budarriola/SolderingIronDriver/README.md

# SolderingIronDriver
Soldering Iron Driver
