budarriola/SolderingIronDriver/Error Log And ToDo List.rtf

Soldering iron Driver Rev. A error log

Problem:
U5 and U3 VSS and VDD are reversed replace I.C. with mcp601R or do mod to correct pins 2/5
Action:
Corrected in new rev. schematic / rev a boards use mcp601r instead

Problem:
R28 is too close to J4
Action:
Moved part on new pcb

Problem:
Potential problem if any button pin was set to output / conflict with programmer
Action:
Added series resistors to button inputs

Problem:
R20 inaccessible when lcd is installed
Action:
moved to other side on new board

Problem:
Serial port TX was not strong enough to push the signal into the adapter
Action:
Changed R9 to 100ohm

Problem:
Leds are too bright
Action:
Increced the value of r18 and r19

ToDo
• Add test points for listed signals
o Vcc, Gnd*2, temp1, temp2, Vref, Heater1, Heater2, Oxing, programing Header, serial port, buttons
• Change L1 from SRR6038-270Y to SRR4018-270Y (http://www.mouser.com/ProductDetail/Bourns/SRR4018-270Y/)
• Change D1, D4, D5, D6, D7 from B360 to B160-E3/5AT (http://www.mouser.com/ProductDetail/Vishay-Semiconductors/B160-E3-5AT/)
• Update terminal block silk screen / make terminal block holes for power sections larger
• Update electrolytic cap silk screen
• Update PCB
