budarriola/SolderingIronDriver/Hardware/sch.jpg

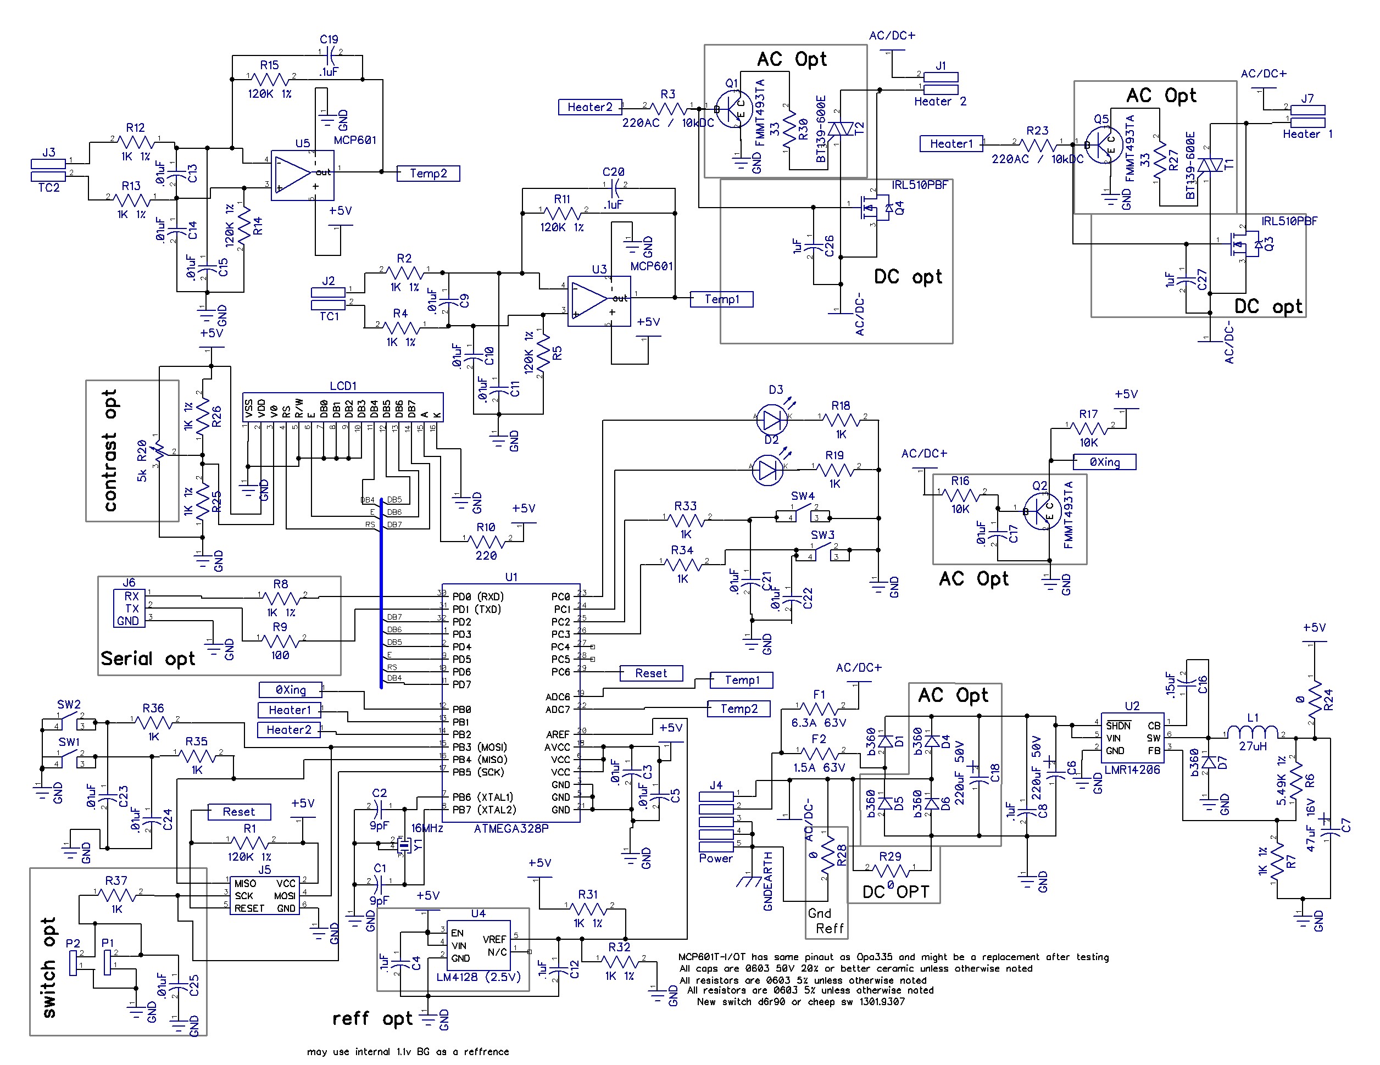
Hardware/sch.jpg
