budarriola/SolderingIronDriver/(list of files, drawings)

Other design files:
Hardware/Gerbers/pcb.dip
Hardware/Gerbers/soldering Station.dch
Hardware/pcb.dip
Hardware/soldering Station.dch
