budarriola/SolderingIronDriver/Software/Soldering Iron Driver/Thermocouple.h

#ifndef Thermocouple_H
#define Thermocouple_H

#include <avr/pgmspace.h>	//used to store the lookup table in flash instead of ram


// lookup table for k type thermocouple held in flash memory -60F to 1000F in 1 degree increments represented in micro volts
static const int16_t lookuptable[1071] PROGMEM =
{
	-1949, -1969, -1988, -2008, -2028, -2048, -2067, -2087, -2106, -2126, -1749, -1770, -1790, -1810, -1830, -1850, -1869, -1889, -1909, -1929, -1547, -1568, -1588, -1608, -1628, -1649, -1669, -1689, -1709, -1729, -1343, -1363, -1384, 
	-1404, -1425, -1445, -1466, -1486, -1507, -1527, -1135, -1156, -1177, -1198, -1218, -1239, -1260, -1281, -1301, -1322, -926, -947, -968, -989, -1010, -1031, -1052, -1073, -1094, -1114, -714, -735, -756, -778, -799, -820, 
	-841, -862, -883, -905, -692, -671, -650, -628, -607, -586, -564, -543, -521, -500, -478, -457, -435, -413, -392, -370, -349, -327, -305, -284, -262, -240, -218, -197, -175, -153, -131, -109, -88, -66, -44, -22, 0, 22, 44, 66, 
	88, 110, 132, 154, 176, 198, 220, 242, 264, 286, 308, 330, 353, 375, 397, 419, 441, 463, 486, 508, 530, 552, 575, 597, 619, 642, 664, 686, 709, 731, 753,776, 798, 821, 843, 865, 888, 910, 933, 955, 978, 1000, 1023, 1045, 1068, 1090,
	 1113, 1136, 1158, 1181, 1203, 1226, 1249, 1271, 1294, 1316, 1339, 1362, 1384, 1407, 1430, 1453, 1475, 1498, 1521, 1543, 1566, 1589, 1612, 1635, 1657, 1680, 1703, 1726, 1749, 1771, 1794, 1817, 1840, 1863, 1886, 1909, 1931, 1954, 1977,
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

	19390, 19414, 19437, 19461, 19485, 19508, 19532, 19556, 19579, 19603, 19626, 19650, 19674, 19697, 19721, 19745, 19768, 19792, 19816, 19839, 19863, 19887, 19910, 19934, 19958, 19981, 20005, 20029, 20052, 20076, 20100, 20123
};
*/
